toammann/BC2_VolCtrl/PCB/BOM/BOM.xlsx

Fitted | Designator | Value | Quantity | Part number | Footprint | Description | Order number | Supplier
Fitted | C1, C12, C14, C21, C22 | 1uF | 5 | GCJ188R71E105KA01D | CAPC1608N | 25V,X5R | 2781410 | Farnell
Fitted | C17 | 100uF | 1 | EEEFK1E101XP | CRAD_6.3mm | Electrolytic, 25V | 1850109 | Farnell
Fitted | C18, C19, C24, C25, C26, C27, C29, C31, C37 | 100nF | 9 | GCJ188R71H104KA12D | CAPC1608N | 50V,X7R | 2688469 | Farnell
Fitted | C2, C3, C20 | 10uF | 3 | CGA5L1X7R1E106K160AC | CAPC3216N | 25V,X7R | 2211068 | Farnell
Fitted | C33, C34 | 15pF | 2 | C1608C0G1H150J080AA | CAPC1608N | 50V,C0G | 1907286 | Farnell
Fitted | C4, C7 | 22uF | 2 | GRM21BR61C226ME44L | CAPC2012N | 10V,X5R | 2688534 | Farnell
Fitted | C5, C6, C13, C15, C16, C23, C28, C30, C32, C35, C36 | 22pF | 11 | GCM1885C1H220JA16D | CAPC1608N | 50V,C0G | 2494189 | Farnell
Fitted | C8, C9, C10, C11 | 1nF | 4 | 06031C102JAT2A | CAPC1608N | 100V,X7R | 1740627 | Farnell
Fitted | D1, D11 |  | 2 | KPTD-1608LVZGCK | LED_0603 | green, 2mA, 2.65V, 0603 | 2610414 | Farnell
Fitted | D10 |  | 1 | KPTD-1608LVVBC-D | LED_0603 | blue, 2mA, 2.65V, 0603 | 2610415 | Farnell
Fitted | D12 |  | 1 | KPTD-1608LVSYCK-J3-PF | LED_0603 | yellow, 2mA, 1.85V, 0603 | 2610413 | Farnell
Fitted | D13 |  | 1 | KPTD-1608LVSECK-J4-PF | LED_0603 | orange, 2mA, 1.8V, 0603 | 2610412 | Farnell
Fitted | D2, D3, D4, D5, D6, D7, D8, D9 |  | 8 | BAT54JFILM | SOD323 | SOD323,2PIN,BAT54JFILM, | 9801502 | Farnell
Fitted | F1 |  | 1 | SF-0603F100-2 | RESC1608N | Fuse | 1652131 | Farnell
Fitted | IC1 |  | 1 | ESP8266 ESP-07 | ESP8266 ESP-12-E | ESP8266 ESP-12-E | 252912268897 | ebay
Fitted | L1 | 4.7uH | 1 | XFL4020-472MEC | L_XFL4020 | Shielded Power Inductor | 2289218 | Farnell
Fitted | L2 | 3.3uH | 1 | XFL4020-332MEB | L_XFL4020 | Shielded Power Inductor | 2289217 | Farnell
Fitted | POT1 | 10k | 1 | RK27112A0-S-25-C0-V103 | RK27112A | 10k, lin, dual | 362309570555 | ebay
Fitted | POT2 | 100k | 1 | RK16814MGA0K | RK16814MGA0K | 100k, log, quad | 1548223 | Rsonline
Fitted | Q1, Q2 |  | 2 | IRF9389TRPBF | SO-8 | nmos | 2579952 | Farnell
Fitted | Q3, Q4, Q5, Q6 |  | 4 | SI1012CR-T1-GE3 | SC-75A | nmos | 2056674 | Farnell
Fitted | R11, R12, R15, R16 | 56k | 4 | CRCW060356K0FKEAHP | RESC1608N | 250mW,75V | 1738928 | Farnell
Fitted | R13, R14, R49 | 100 | 3 | CRCW0603100RFKEAHP | RESC1608N | 250mW,75V | 1738891 | Farnell
Fitted | R25, R26 | 330 | 2 | CRCW0603330RFKEAHP | RESC1608N | 250mW,75V | 1738898 | Farnell
Fitted | R28 | 1.5k | 1 | CRCW06031K50FKEA | RESC1608N | 100mW,75V | 1469743 | Farnell
Fitted | R3 | 187k | 1 | ERJ3EKF1873V | RESC1608N | 100mW,75V | 2303248 | Farnell
Fitted | R31, R39 | 4k99 | 2 | CRCW06034K99FKEA | RESC1608N | 100mW,75V | 1652885 | Farnell
Fitted | R37, R48 | 750 | 2 | CRCW0603750RFKEA | RESC1608N | 100mW,75V | 1652900 | Farnell
Fitted | R4, R40, R58 | 115k | 3 | CRCW0603115KFKEA | RESC1608N | 100mW,75V | 2138503 | Farnell
Fitted | R5, R6 | 25k5 | 2 | CRCW060325K5FKEA | RESC1608N | 100mW,75V | 2138447 | Farnell
Fitted | R7, R10, R54, R55 | 8.2k | 4 | CRCW06038K20FKEAHP | RESC1608N | 250mW,75V | 1738917 | Farnell
Fitted | R8, R9 | 47k | 2 | CRCW060347K0FKEAHP | RESC1608N | 250mW,75V | 1738927 | Farnell
Fitted | TP1, TP2, TP3, TP4 |  | 4 | NA | TP_0.3mm | Testpoint | NA | NA
Fitted | U1 |  | 1 | LTC3622HDE-2#PBF | DFN-14 | Buck, 2 Channel, 2.25MHz | 2483300 | Farnell
Fitted | U2 |  | 1 | LDLN015PU18R | DFN6 | Low dropout regulator | 2460822 | Farnell
Fitted | U3 |  | 1 | ATMEGA328PB-MN | ATMEL_32M1-A_L | 8Bit MCU | 2920865 | Farnell
Fitted | U4, U5 |  | 2 | SN74LVC2T45DCTR | SSOP-8_DCT | Bus-Transceiver | 2854638 | Farnell
Fitted | X1 |  | 1 | TSW-102-07-G-S | HDR2x1 | 2-Pin, Header, 2.54mm | 2505044 | Farnell
Fitted | X2, X4 |  | 2 | 22-28-4032 | HDR3x1 | 3-Pin, Header, 2.54mm | 2751450 | Farnell
Fitted | X3, X5, X6, X7 |  | 4 | 39-28-1043 | MOLEX_MINI_FIT_4PIN | Header, 4-Pin | 9732098 | Farnell
Fitted | X8, X9 |  | 2 | 61300621121 | HDR2X3_1_15_Drill | 6-Pin, Header, 3x2, Dual row | 2356131 | Farnell
Fitted | Y1 |  | 1 | ABM3B-8.000MHZ-10-1-U-T | XTAL_5x3.2mm | 8MHz, 10ppm, 10pF | 2467817 | Farnell
Fitted, Fitted, Fitted, Fitted, Fitted, Fitted, Not Fitted | R34, R35, R41, R44, R45, R52, R57 | 1k | 6 | CRCW06031K00FKEA | RESC1608N | 100mW,75V | 1469740 | Farnell
Fitted, Fitted, Fitted, Not Fitted, Not Fitted | FB1, FB2, FB4, FB5, FB6 |  | 3 | 742792097 | 0805_FERRITE | Z=1.5k@100MHz, 1A, R=300mOhm | 1635738 | Farnell
Fitted, Not Fitted, Fitted, Fitted, Fitted, Fitted, Fitted, Fitted, Fitted | R29, R36, R38, R43, R46, R47, R51, R53, R56 | 0 | 8 | CRCW06030000Z0EA | RESC1608N | 100mW,75V | 1469739 | Farnell
Fitted, Not Fitted, Fitted, Fitted, Not Fitted, Fitted, Fitted, Not Fitted, Fitted, Not Fitted, Fitted, Fitted, Fitted, Fitted, Fitted, Fitted | R1, R2, R17, R18, R19, R20, R21, R22, R23, R24, R27, R30, R32, R33, R42, R50 | 10k | 12 | CRCW060310K0FKEAHP | RESC1608N | 250mW,75V | 1738918 | Farnell
