toammann/BC2_VolCtrl/PCB/PDF/BC2_VolCtrl_Schematic.pdf

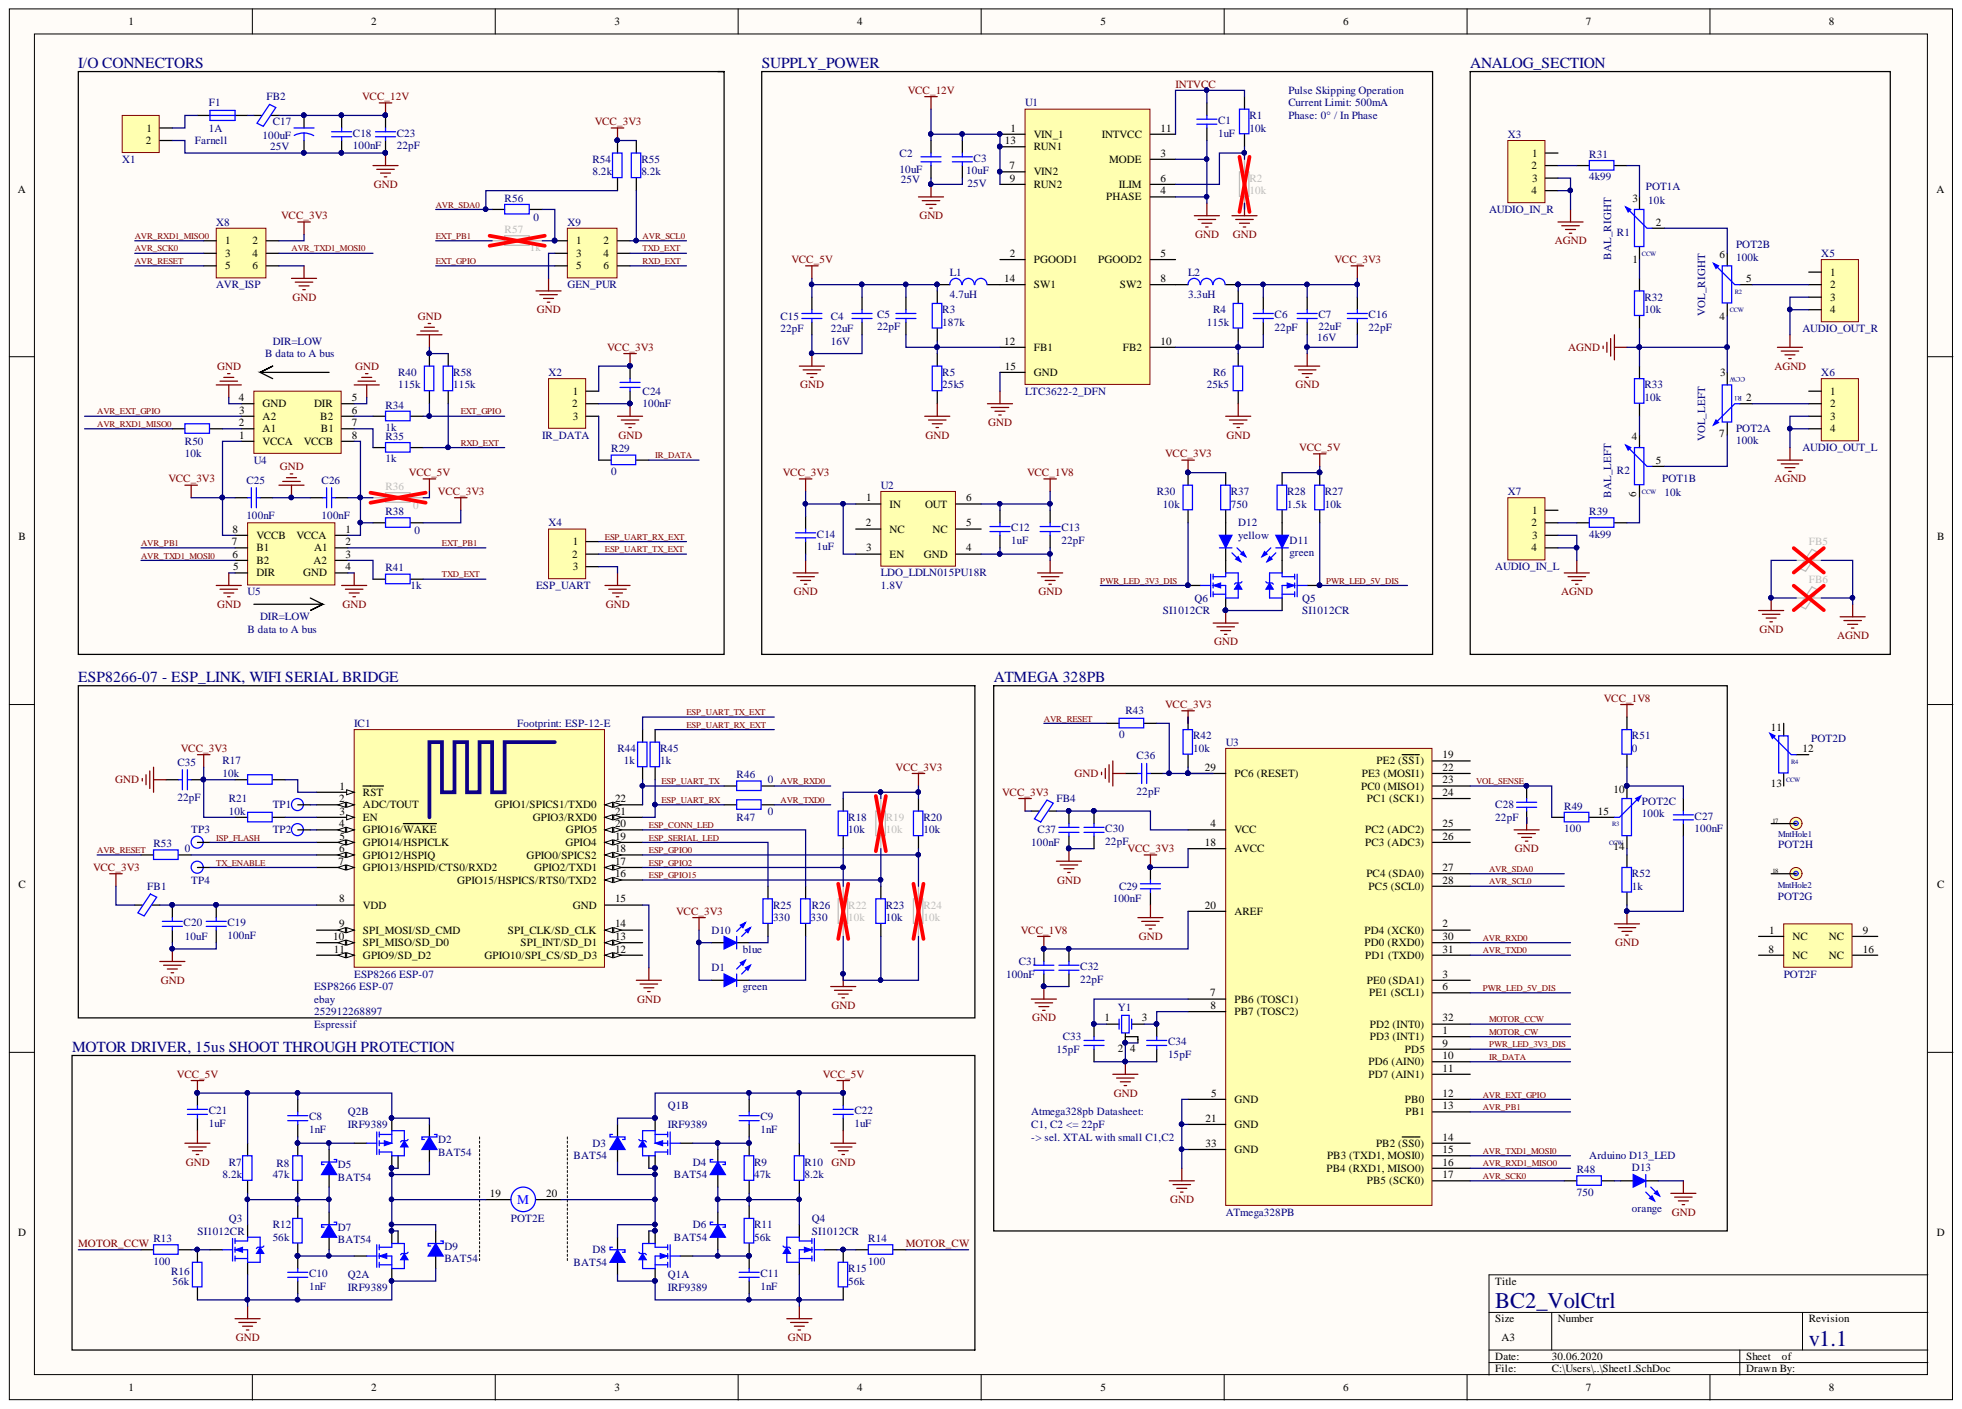
[picture p8: page 1]

MOTOR DRIVER, 15us SHOOT THROUGH PROTECTION
