toammann/BC2_VolCtrl/PCB/PDF/BC2_VolCtrl_Board_Stack.pdf

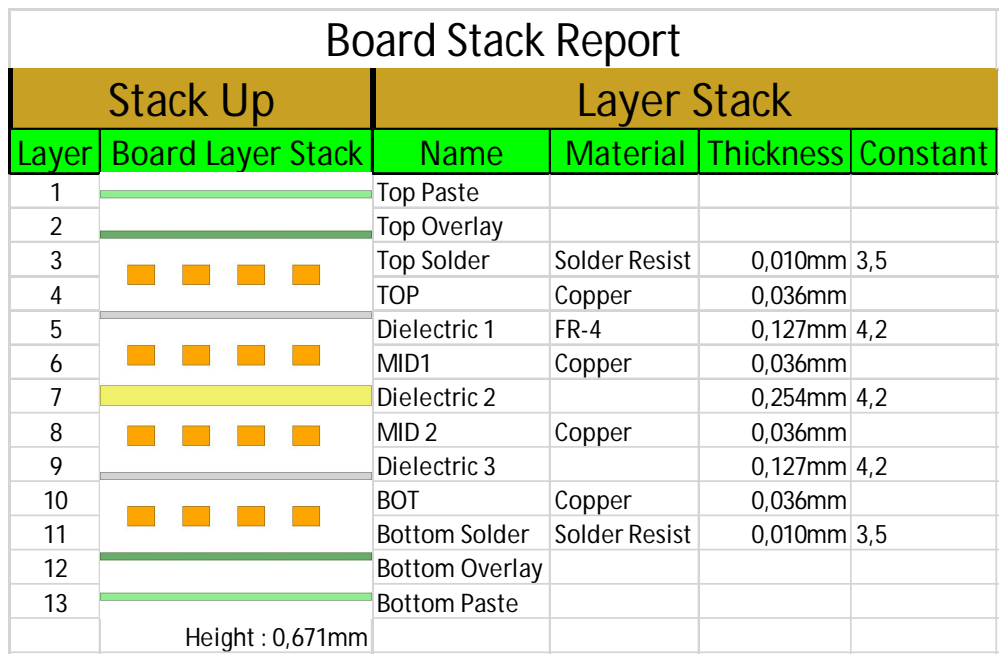
[picture p9: page 1]

Stack Up | Layer Stack
Layer | Board Layer Stack | Name | Material | Thickness | Constant
1 | | Top Paste
2 | | Top Overlay
3 | | Top Solder | Solder Resist | 0,010mm | 3,5
4 | | TOP | Copper | 0,036mm
5 | | Dielectric 1 | FR-4 | 0,127mm | 4,2
6 | | MID1 | Copper | 0,036mm
7 | | Dielectric 2 | | 0,254mm | 4,2
8 | | MID 2 | Copper | 0,036mm
9 | | Dielectric 3 | | 0,127mm | 4,2
10 | | BOT | Copper | 0,036mm
11 | | Bottom Solder | Solder Resist | 0,010mm | 3,5
12 | | Bottom Overlay
13 | | Bottom Paste

Height : 0,671mm
