toammann/BC2_VolCtrl/PCB/PDF/BC2_VolCtrl_Assembly.pdf

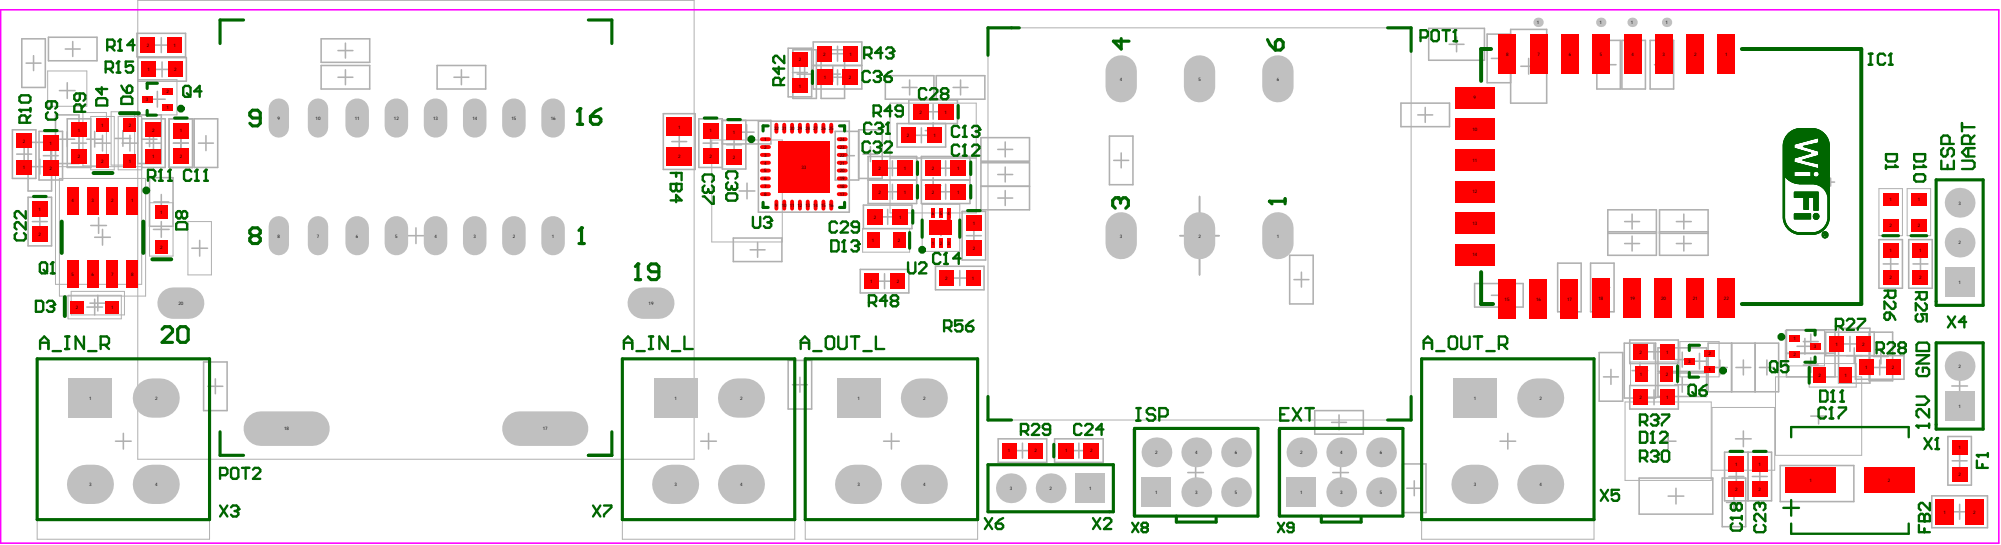
[picture p10: page 1]

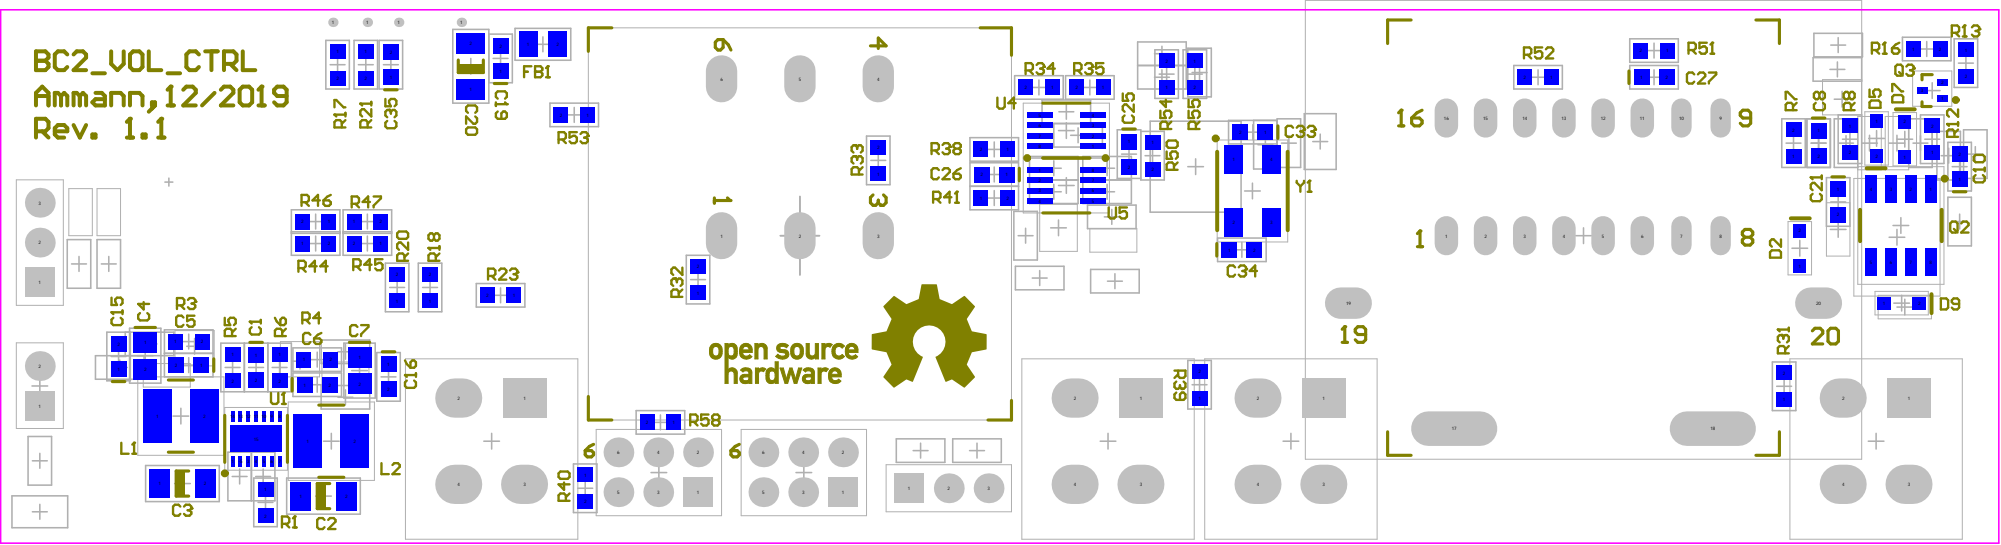
[picture p11: page 2]
