toammann/BC2_VolCtrl/PCB/PDF/BC2_VolCtrl_Validation.pdf

### Electrical Rules Check Report

Class | Document | Message
Warning | Sheet1.SchDoc | Off grid Net Label VOL_SENSE at 1169.656,490
Samstag 21 Mrz 2020 4:26:48 PM | Page 1 of 1

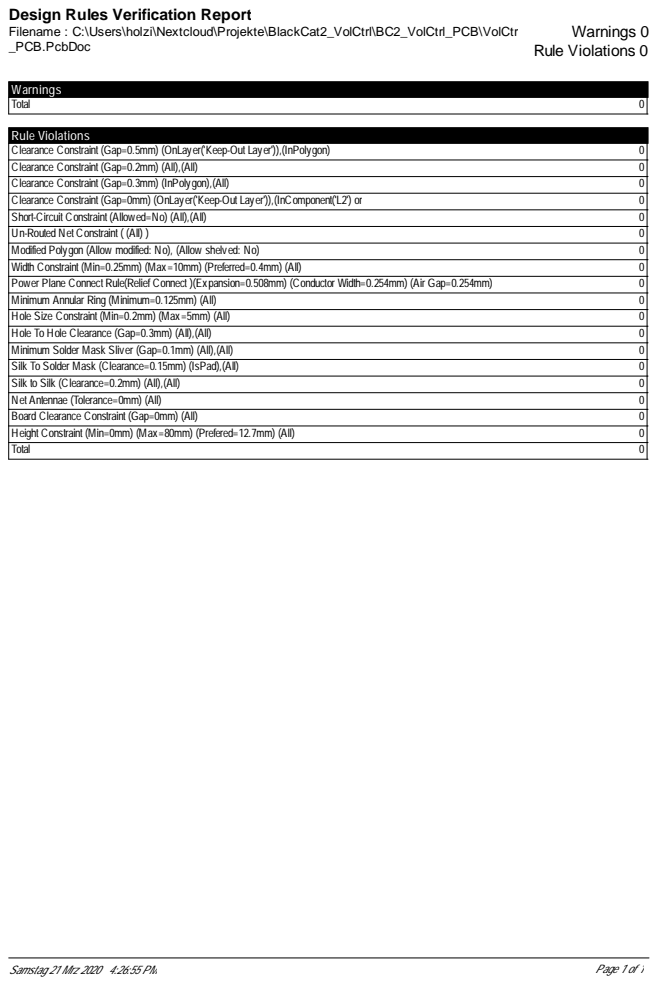
[picture p12: page 2]

Design Rules Verification Report
Filename : C:\Users\holzi\Nextcloud\Projekte\BlackCat2_VolCtrl\BC2_VolCtrl_PCB\VolCtr
_PCB.PcbDoc

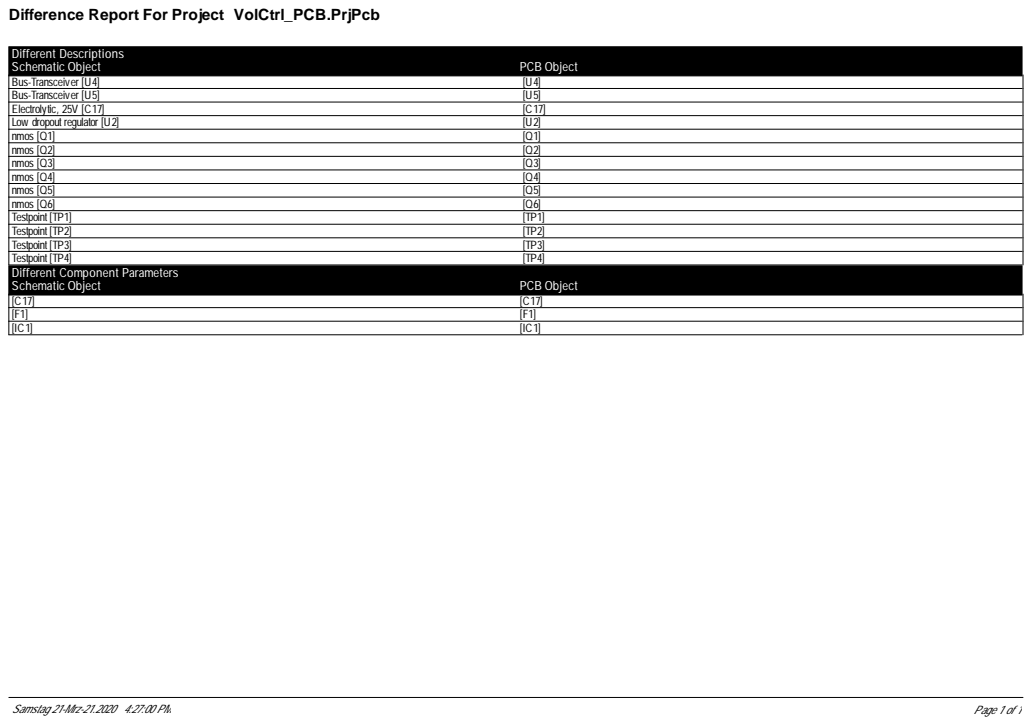
[picture p13: page 3]

Difference Report For Project VolCtrl_PCB.PrjPcb
