toammann/BC2_VolCtrl/PCB/PDF/VolCtrl_PCB_3D_Perspective.pdf

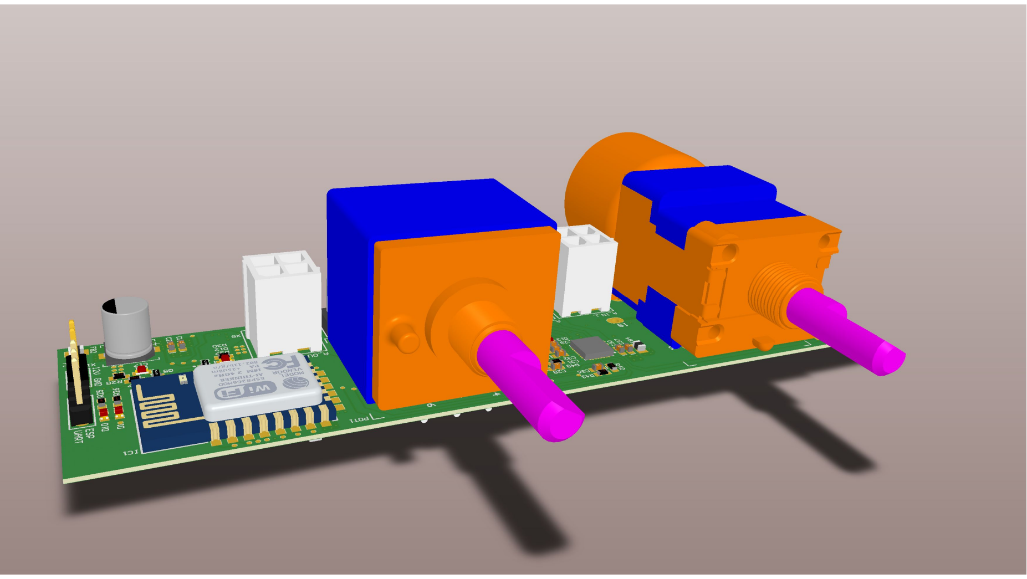
[picture p14: page 1]
