toammann/BC2_VolCtrl/(commit log)

2019-03-26 double error message fixed
    [main.c, uart.c]
2019-07-01 implemented adc
2019-12-02 added pcb
    [AssemblyTOP_BOT.xlsx, BOM.xlsx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]
2020-01-02 added i2c to ext connector
    [AssemblyTOP_BOT.xlsx, BOM.xlsx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]
2020-01-07 fixed bom error
    [AssemblyTOP_BOT.xlsx, BOM.xlsx]
2020-01-07 update schematic
2020-01-08 update gerber
    [AssemblyTOP_BOT.xlsx, BOM.xlsx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]
2020-01-08 update drills
2020-03-21 Fixed Silkscreen error
    [VolCtrl_PCB.GTO]
